Lakemast/WifiCar/WifiCar-PCB/altium_library_brasil-master/README.md

<h1>Bem-Vindo à Altium Library Brasil</h1>

Está é uma Biblioteca de Componentes para o software Altium Design Comunitaria, ela foi pensada em facilitar a vida dos usuarios que precisam gerar a lista de Bill Of Materials para manufaturação de seus produtos ou prototipos.

Contribua incluindo o seu componentes, mas se atente as regras de criação, só assim é possivel manter a biblioteca sempre atualizada.

<h1>Padrão para Schematico</h1>

Todos esquematicos devem conter os seguintes valores

<ul>
  <li>Descrição</li>
  <li>Valor</li>
  <li>Encapsulamento</li>
  <li>Marca</li>
  <li>Modelo</li>
  <li>Observação</li>
</ul>

<h1>Pagina Wiki</h1>

<div><a href="https://github.com/adrianlemos/altium_library_brasil/wiki">Caso queira saber maiores informações de Como fazer Download, Instalar e modificar a Biblioteca, Clique Aqui.</a></div>

<h1>Lista de Componentes</h1>

<h2>Conectores</h2>
<ul>
	<li>Barra de Pinos 2x3 6 vias 180º</li>
	<li>Barra de Pinos 2x4 8 vias 90º</li>
	<li>Barra de Pinos 2x6 12 vias 90º</li>
	<li>Barras de Pinos 3 vias com Jumper</li>
	<li>Jack P4</li>
	<li>Conector KK 3 vias 180º</li>
	<li>Conector BR3R 5 vias 90º</li>
	<li>Conector KK 2 Vias 180º</li>
	<li>Conector Header Sem Ejetor 2x5 10 vias PTH 90º e 180º</li>
	<li>Conector Header Sem Ejetor 2x8 16 vias PTH 90º e 180º</li>
	<li>Conector BR8 3 Vias 90º e 180º</li>
	<li>Conector KRE 2 vias 180º</li>
	<li>Conector KRE 3 vias 180º</li>
</ul>

<h2>Microcontroladores</h2>
<ul>
	<li>ARM Cortex M3 LPC1756 SMD</li>
	<li>ATmega328-AU SMD TQFP32</li>
	<li>ATmega328-PU PTH DIP28</li>
	<li>Microchip 16F628A PTH DIP18</li>
	<li>NXP P80C552EFA</li>
</ul>

<h2>Modulos</h2>
<u>
	<li>Módulo Arduino Pro Mini</li>
	<li>Módulo Wi-Fi ESP-12F</li>
	<li>Módulo Wi-Fi ESP-32</li>
	<li>Módulo Wi-Fi ESP-01</li>
	<li>Display LCD 8x2 YB802-B</li>	
</u>

<h2>Componentes Passivos</h2>
<ul>
	<li>Resistor 	SMD 2512, 2010, 1206, 0805, 0603, 0402</li>
	<li>Capacitor 	SMD 1206, 0805, 0603, 0402</li>
	<li>Capacitor de Tantalo SMD Case B</li>
	<li>Cristal SMD HC49S </li>
	<li>Indutor PTH Carretel 10mm x 12mm 700mA</li>
	<li>Capacitor Eletrolitico Basico PTH com Footprint (Largura x Altura x Passo_do_Pad) 4x5x1.6mm, 5x11x2.54mm, 6.3x11x2.54mm, 8x11x3.5mm, 10x12.5x5.08mm, 10x16x5.08mm, 10x20x5.08mm, 12.5x20x5.08mm, 16x20x7.62mm, 16x25x7.62mm, 16x31.5x7.62mm - SMD </li>
	<li>Capacitor Ceramico PTH com Passo de 5.08mm</li>
	<li>Módulo Ultraminiatura Rele MA1RC2</li>
	<li>Buzzer 5V PTH 180º</li>
	<li>Chave Tact PTH 6x6x5mm</li>
	<li>Chave Tact SMD 6x6x7mm com LED</li>
	<li>Resistor Array 7 vias</li>

</ul>

<h2>Componentes Semicondutores</h2>
<ul>
	<li>Transistor PTH NPN BC550</li>
	<li>Transistor PTH PNP BC560</li>
	<li>Transistor SMD PNP BC807</li>
	<li>Transistor SMD NPN BC817</li>
	<li>OptoAcoplador SMD e PTH PC817</li>
	<li>OptoAcoplador SMD e PTH 4N35</li>
	<li>OptoAcoplador SMD e PTH 6N137</li>
	<li>Regulador de Tensão LM1117 SMD</li>
	<li>OptoAcoplador SMD e PTH MOC3052</li>
	<li>Transiver RS485 MAX485 SMD e PTH</li>
	<li>Diodo SMD LL4148</li>
	<li>Led SMD 1206, 0805 - Sem Cor</li>
	<li>Led 3mm Cores: Amarelo, Azul, Verde, Vermelho PTH</li>
	<li>Led 5mm Cores: Amarelo, Azul, Verde, Vermelho PTH</li>
	<li>Regulador de Tensão 5V 78L05ACM SMD</li>
	<li>Regulador de Tensão 3V3 78L33 SMD e PTH</li>
	<li>Regulador de Tensão fixo e variavel LM2756 SMD, PTH e PTH 90º</li>
	<li>Diodo Schottky SS34 SMD</li>
	<li>Regulador de Tensão LM7805 PTH TO-220 e TO-220 90º</li>
	<li>Sensor de Efeito Hall USS1881 PTH </li>
	<li>Diodo Zenner BZX84 SMD</li>
	<li>Memória EEPROM 24LC64 PTH</li>
	<li>Circuito Integrado Shift Register 74HC595 SMD</li>
	<li>Circuito Integrado MUX 74HC4051</li>
	<li>Transistor PNP Média Potencia BD244</li>
	<li>Diodo Zenner 3V6 SMD</li>
	<li>Diodo Retificador M7</li>
	<li>Diodo de Proteção ESDA6V1L SMD</li>
	<li>Regulador de Tensão LM317 PTH</li>
	<li>Regulador de Tensão LM2576 PTH 90 e 180º, SMD</li>
	<li>Regulador de Tensão Variavel MC34063AD SMD</li>
	<li>Driver de CAN PCA82C251 SMD</li>
	<li>Diodo de Proteção ESD de Rede CAN PESD1CAN</li>
	<li>Diodo Shottky 3A 40V SMAJ26 SMD</li>
	<li>Diodo Shottky SS14 SMD </li>
	<li>Diodo Shottky SS34 SMD </li>
	<li>Transistor NPN de Média Potencia TIP122</li>
	<li>Transistor PNP de Média Potencia TIP127</li>
	<li>TRIAC BTA41-600B PTH </li>
</ul>
