Lakemast/WifiCar/README/voltagedivider.PNG

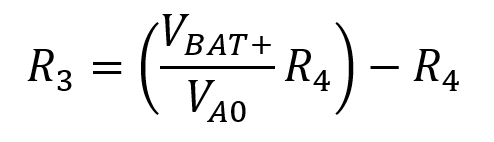
README/voltagedivider.PNG
