Lakemast/WifiCar/(threads)

Thread 1 (2023-01-21):

Can't receive video streaming from WAN

rikiata, 2023-01-21:
Sir,I cant receive espcam32 mqtt image on app.How to cofigure the code or app to receive live video in app?

Lakemast, 2023-01-21:
Hi Friend,

First your smartphone needs to be connected to same WiFi network of your ESP32.
Second you need to change to your **ESP32 IP** the field **Camera URL**  in the APP **Settings**:

- http://**<your_ESP32_IP>**:81/stream
(_replace **<your_ESP32_IP>** with your **ESP32 IP**_)

To do that you need to know what is your **ESP32 IP**.

If you know your **ESP32 IP**  run this small test to ensure your ESP32 is running:
- Open your browser and type your **ESP32 IP** in your web browser
- Something like this image will show

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

Notice that my **ESP32 IP** is  **192.168.15.41** in my LAN (Local Area Network). Now click on _START STREAM_ and some like below the video stream should be shown in your browser.

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

If none of that works please let me know what is your Android Version.

rikiata, 2023-01-21:
Friend,I can access live video on browser(phone or laptop on same wifi.I have changed camera url- http://192.168.1.102:81/stream
but I cant stream video on app screen through mqtt(anywhere in the world).But I can control servo and the motors,Please help.

Lakemast, 2023-01-21:
What is your Android Version ?

Could you please attach a image from app home and settings screen?

Lakemast, 2023-01-21:
Did you install the app through .apk or through Android Studio ?

rikiata, 2023-01-21:
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

ANDROID 10 VERSION

rikiata, 2023-01-21:
I installed the app through apk

rikiata, 2023-01-21:
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

Lakemast, 2023-01-21:
Hi Friend,

I updated the app. Try to install this new uploaded apk [WiFiCar-fixed.apk](https://github.com/Lakemast/WifiCar/blob/master/WiFiCarMQTT/WiFiCar-fixed.apk)

Tell me if it worked.

rikiata, 2023-01-21:
It's working on local wifi. But when I try to connect(4g mobile)  with mqtt, I can control motor,servo and espcam led from anywhere. But can't monitor live video on app.

rikiata, 2023-01-21:
I want to control the car from anywhere in the world through mqtt with live video streaming.

Is it possible?

Lakemast, 2023-01-21:
I got it.

As far as I know MQTT is not a protocol for streaming video.  The only workaround that I know is you make your ESP32 IP static on your Router and use Port Routing and DDNS to access your video stream.

That's why I wrote a disclaimer on project description saying that WAN will require some workaround.

On your Router, you will need to reserve an IP address to ESP32

So you will need sign up at a DDNS provider like  NOIP and register a Domain. _Example: wificar.ddns.net_ and turn up DDNS feature on Router and log in.

After that you need to assign this domain to your  gateway and then port forward to ESP 32 IP and port 81.

I know some chinese cameras app do that with all this workaround, but I didn't find out yet how to do it.

Lakemast, 2023-01-21:
If you do this work around it is possible that video streaming delay will be huge.

Lakemast, 2023-01-21:
Sorry I forgot to say at you do all I said, you will need to change in the App the camera URL with your domain _Example: http://wificar.ddns.net/

rikiata, 2023-01-21:
Did you test the esp32cam on ddns?worked?
Can I use raspberri pi camera url(internet streaming) on your app? If possible, I can control the motors and servo through matt and video streaming through raspberri pi camera.

Or. Can I use v380 camera with your app?

Please suggest.

rikiata, 2023-01-21:
I watched your YouTube video. Video streaming is ddns based or wifi based?

Lakemast, 2023-01-21:
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

Yes I've tested esp32 cam using ddns. It worked but not as expected. The video delay was huge.

Yes, if your camera url is a MJPEG stream you can use my app with raspberry pi camera or any MJPEG camera.

My app used this other repository to stream video
[perthcpe23/android-mjpeg-view)](https://github.com/perthcpe23/android-mjpeg-view)

rikiata, 2023-01-21:
Can you suggest any readymade mjpeg camera?

Lakemast, 2023-01-21:
> I watched your YouTube video. Video streaming is ddns based or wifi based?

None of them.

DDNS stands for Dynamic Domain Name System and is used to translate IP to domains
_example: 142.251.132.238 to google.com_

WiFi is a wireless networking technology that uses radio waves to provide wireless high-speed Internet access. So WiFi basically connects your devices like phone, pc to the router.

Video streaming can be based on several protocols like : RSTP, ONVIF, MJPEG over HTTP and many others.

Lakemast, 2023-01-21:
> Can you suggest any readymade mjpeg camera?

Sorry, but I've worked only with theses modular cameras like esp32cam or raspberry pi cameras.

rikiata, 2023-01-21:
Thanks for your valuable ideas. I will try to make
Mjpeg based raspberri pi internet camera. Then I can control the car from anywhere with live video streaming.

Lakemast, 2023-01-21:
> Thanks for your valuable ideas. I will try to make
> Mjpeg based raspberri pi internet camera. Then I can control the car from anywhere with live video streaming.

You are welcome! Maybe you can find some repository in github to help with at.

Closed 2023-01-21.

Thread 2 (2023-03-01):

Motor always active

rikiata, 2023-03-01:
Dear friend,

I tried to build the hardware.I am facing following errors

1. Motor is automatically switched on whenever I apply power
2. One motor rotates and breaks- continue
3. Ultrasonic sensor is not working
please help

Closed 2023-03-15.
