Lakemast/WifiCar/WifiCar-PCB/WiFiCar-Schematic.pdf

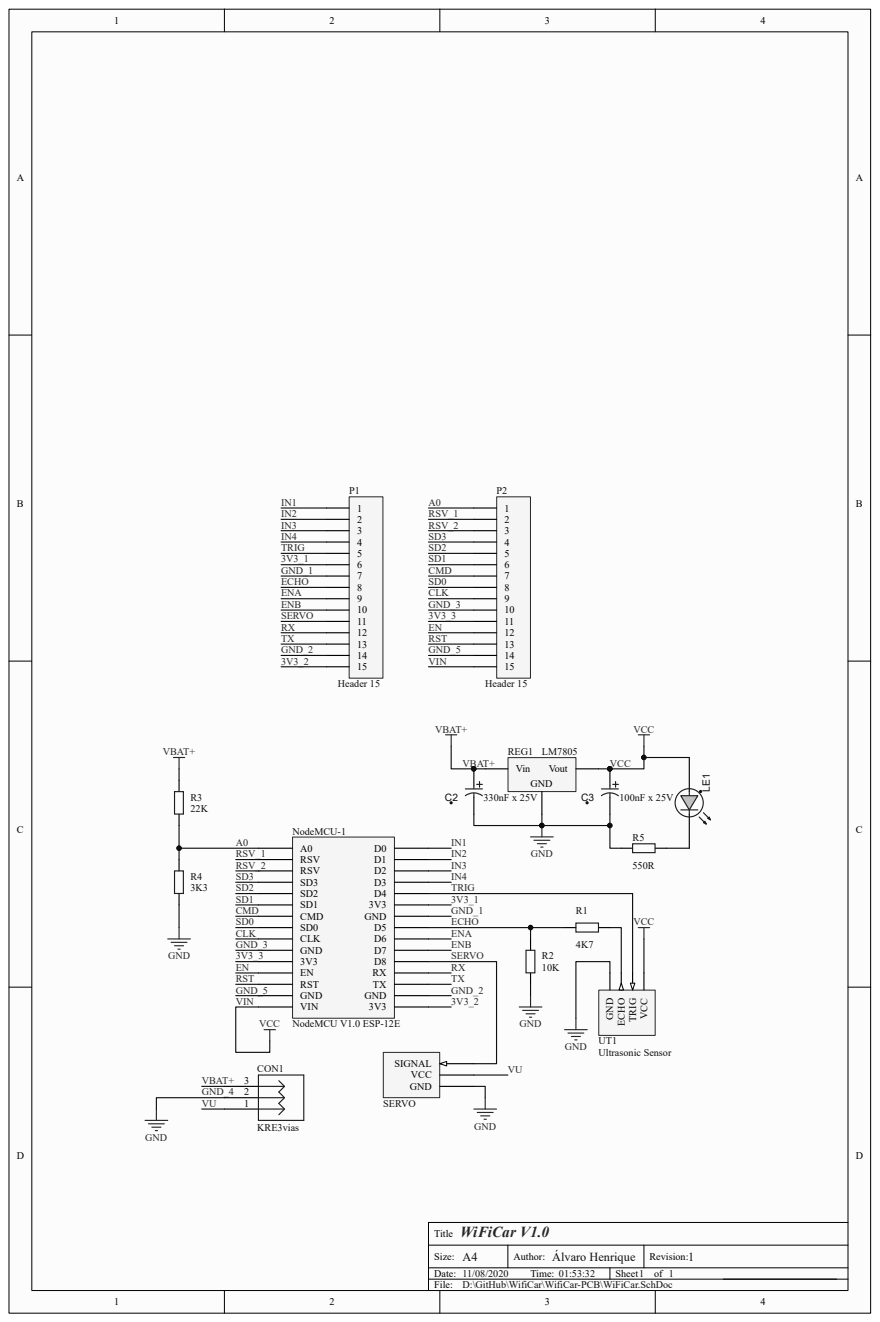
[picture p7: page 1]

WiFiCar V1.0
Title
Size:
D:\GitHub\WifiCar\WifiCar-PCB\WiFiCar.SchDoc
