Lakemast/WifiCar/WifiCar-PCB/WifiCar-PCB-TRANSFER.pdf

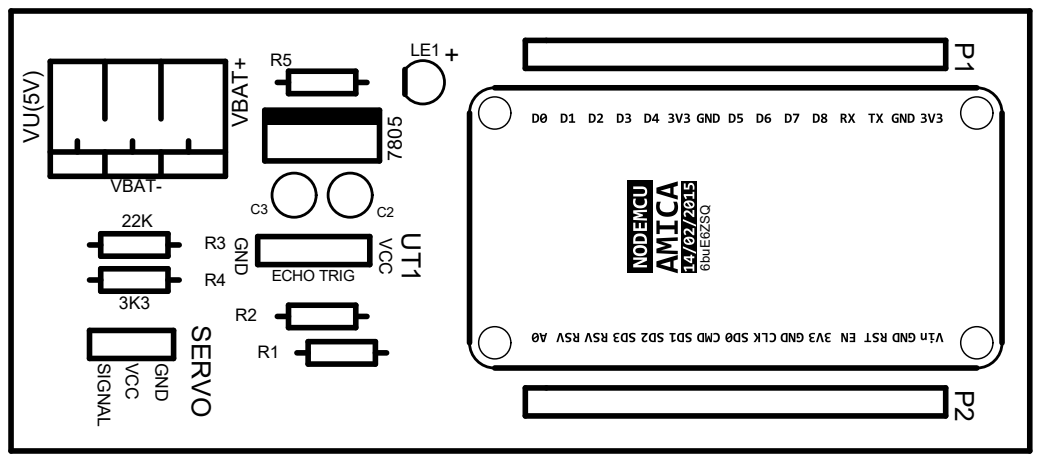
[picture p8: page 1]

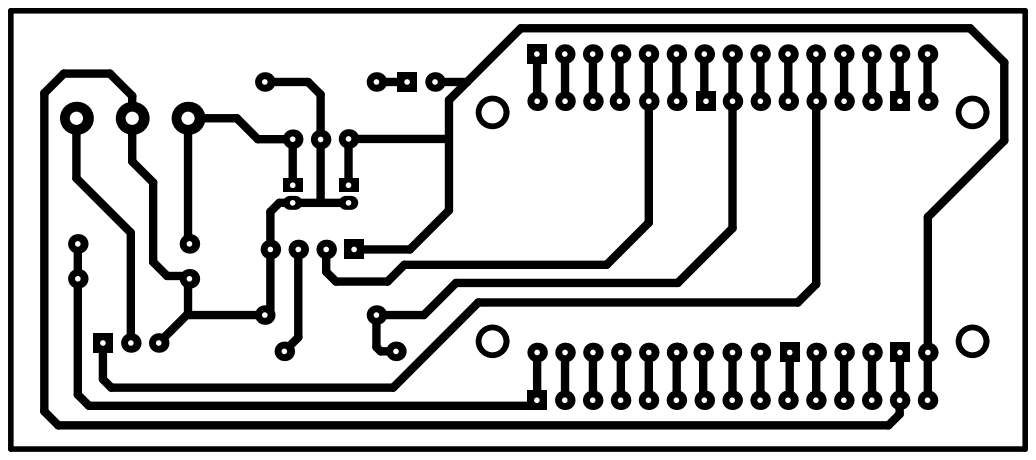
[picture p9: page 2]
