Lakemast/WifiCar/(list of files, drawings)

Other design files:
WifiCar-PCB/altium_library_brasil-master/Altium_Library_Brasil/Conectores_Ftp.PcbLib
WifiCar-PCB/altium_library_brasil-master/Altium_Library_Brasil/Conectores_Sch.SchLib
WifiCar-PCB/altium_library_brasil-master/Altium_Library_Brasil/Geral_Footprints.PcbLib
WifiCar-PCB/altium_library_brasil-master/Altium_Library_Brasil/Microcontroladores_Ftp.PcbLib
WifiCar-PCB/altium_library_brasil-master/Altium_Library_Brasil/Microcontroladores_Sch.SchLib
WifiCar-PCB/altium_library_brasil-master/Altium_Library_Brasil/Modulos_Sche.SchLib
WifiCar-PCB/altium_library_brasil-master/Altium_Library_Brasil/Passivos_Ftp.PcbLib
WifiCar-PCB/altium_library_brasil-master/Altium_Library_Brasil/Passivos_Sche.SchLib
WifiCar-PCB/altium_library_brasil-master/Altium_Library_Brasil/Semicondutores_Ftp.PcbLib
WifiCar-PCB/altium_library_brasil-master/Altium_Library_Brasil/Semicondutores_Sche.SchLib
WifiCar-PCB/WIFICAR.PcbLib
WifiCar-PCB/WifiCar.PrjPcb
WifiCar-PCB/WiFiCar.SchDoc
WifiCar-PCB/WifiCar.SCHLIB
WifiCar-PCB/WifiCarPcbDoc.PcbDoc
