Lakemast/WifiCar/WiFiCarMQTT/app/src/main/java/com/example/wificar/mqtt/PahoMqttClient.java

package com.example.wificar.mqtt;

import android.content.Context;
import android.content.SharedPreferences;
import android.util.Log;

import androidx.annotation.NonNull;

import org.eclipse.paho.android.service.MqttAndroidClient;
import org.eclipse.paho.client.mqttv3.DisconnectedBufferOptions;
import org.eclipse.paho.client.mqttv3.IMqttActionListener;
import org.eclipse.paho.client.mqttv3.IMqttToken;
import org.eclipse.paho.client.mqttv3.MqttConnectOptions;
import org.eclipse.paho.client.mqttv3.MqttException;
import org.eclipse.paho.client.mqttv3.MqttMessage;

import java.io.UnsupportedEncodingException;

/**
 * Created by brijesh on 20/4/17.
 */

public class PahoMqttClient {

    private static final String TAG = "PahoMqttClient";
    public MqttAndroidClient mqttAndroidClient;
    private SharedPreferences sharedPreferences;
    private String clientid = "", urlBroker = "", username = "", password = "", subscribeTopic = "", publishTopic = "";
    private final static String PREF_BROKER = "PREF_BROKER", PREF_USERNAME = "PREF_USERNAME", PREF_PASSWORD = "PREF_PASSWORD",
            PREF_SUBSCRIBE = "PREF_SUBSCRIBE", PREF_PUBLISH = "PREF_PUBLISH",
            PREF_MAX_SPEED_MOTOR_A = "PREF_MAX_SPEED_MOTOR_A", PREF_MAX_SPEED_MOTOR_B = "PREF_MAX_SPEED_MOTOR_B";


    public MqttAndroidClient getMqttClient(Context context, String brokerUrl, String clientId, String clientUn, String clientPw) {
        mqttAndroidClient = new MqttAndroidClient(context, brokerUrl, clientId);
        try {
            MqttConnectOptions myMqttcnxoptions = getMqttConnectionOption();
            if(clientUn.trim().length() > 0) {
                myMqttcnxoptions.setUserName(clientUn);
            }
            if(clientPw.trim().length() > 0) {
                myMqttcnxoptions.setPassword(clientPw.toCharArray());
            }
            IMqttToken token = mqttAndroidClient.connect(myMqttcnxoptions);

            //IMqttToken token = mqttAndroidClient.connect(getMqttConnectionOption(clientUn,clientPw));
            token.setActionCallback(new IMqttActionListener() {
                @Override
                public void onSuccess(IMqttToken asyncActionToken) {
                    mqttAndroidClient.setBufferOpts(getDisconnectedBufferOptions());
                    Log.d(TAG, "Success");
                }

                @Override
                public void onFailure(IMqttToken asyncActionToken, Throwable exception) {
                    Log.d(TAG, "Failure " + exception.toString());
                }
            });
        } catch (MqttException e) {
            e.printStackTrace();
        }

        return mqttAndroidClient;
    }

    public void disconnect(@NonNull MqttAndroidClient client) throws MqttException {
        IMqttToken mqttToken = client.disconnect();
        mqttToken.setActionCallback(new IMqttActionListener() {
            @Override
            public void onSuccess(IMqttToken iMqttToken) {
                Log.d(TAG, "Successfully disconnected");
            }

            @Override
            public void onFailure(IMqttToken iMqttToken, Throwable throwable) {
                Log.d(TAG, "Failed to disconnected " + throwable.toString());
            }
        });
    }

    @NonNull
    private DisconnectedBufferOptions getDisconnectedBufferOptions() {
        DisconnectedBufferOptions disconnectedBufferOptions = new DisconnectedBufferOptions();
        disconnectedBufferOptions.setBufferEnabled(true);
        disconnectedBufferOptions.setBufferSize(100);
        disconnectedBufferOptions.setPersistBuffer(false);
        disconnectedBufferOptions.setDeleteOldestMessages(false);
        return disconnectedBufferOptions;
    }

    @NonNull
    private MqttConnectOptions getMqttConnectionOption() {

        //private MqttConnectOptions getMqttConnectionOption(String clientUn, String clientPw) {
        MqttConnectOptions mqttConnectOptions = new MqttConnectOptions();
        mqttConnectOptions.setCleanSession(false);
        mqttConnectOptions.setAutomaticReconnect(true);
        //mqttConnectOptions.setWill(Constants.PUBLISH_TOPIC, "I am going offline".getBytes(), 1, true);
        //mqttConnectOptions.setUserName("dave_test1");
        //mqttConnectOptions.setPassword("dave_test123".toCharArray());
        //mqttConnectOptions.setUserName(un);
        //mqttConnectOptions.setPassword(clientPw.toCharArray());
        return mqttConnectOptions;
    }

    public void publishMessage(@NonNull MqttAndroidClient client, @NonNull String msg, int qos, @NonNull String topic)
            throws MqttException, UnsupportedEncodingException {
        byte[] encodedPayload = new byte[0];
        encodedPayload = msg.getBytes("UTF-8");
        MqttMessage message = new MqttMessage(encodedPayload);
        message.setId(320);
        message.setRetained(true);
        message.setQos(qos);
        client.publish(topic, message);
    }

    public void subscribe(@NonNull MqttAndroidClient client, @NonNull final String topic, int qos) throws MqttException {
        IMqttToken token = client.subscribe(topic, qos);
        token.setActionCallback(new IMqttActionListener() {
            @Override
            public void onSuccess(IMqttToken iMqttToken) {
                Log.d(TAG, "Subscribe Successfully " + topic);
            }

            @Override
            public void onFailure(IMqttToken iMqttToken, Throwable throwable) {
                Log.e(TAG, "Subscribe Failed " + topic);

            }
        });
    }

    public void unSubscribe(@NonNull MqttAndroidClient client, @NonNull final String topic) throws MqttException {

        IMqttToken token = client.unsubscribe(topic);

        token.setActionCallback(new IMqttActionListener() {
            @Override
            public void onSuccess(IMqttToken iMqttToken) {
                Log.d(TAG, "UnSubscribe Successfully " + topic);
            }

            @Override
            public void onFailure(IMqttToken iMqttToken, Throwable throwable) {
                Log.e(TAG, "UnSubscribe Failed " + topic);
            }
        });
    }

}
