Lakemast/WifiCar/(commit log)

2020-05-07 teste de commit no arquivo gitTest.txt
2020-05-08 Criação da primeira versão dos sketchs para o NodeMCU
2020-05-09 motors and ultrasonic functions implemented
2020-05-09 Trying to work with a servo
2020-05-10 Improvement on ultrasonic
2020-05-10 Improvement on decteting and avoiding obstacles.
    [motors.ino, mqtt.ino, ultrasonic.ino]
2020-05-11 Battery Voltmeter implemented
2020-05-11 Improvement on detecting and avoiding obstacles.
    [ultrasonic.ino]
2020-05-12 Added schematics and pcb layouts
    [WiFiCar.SchDoc, WifiCar.PrjPcb, WifiCar.SCHLIB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]
2020-05-12 WiFiCar PDF schematic
2020-05-13 PCB and Schematics fixed; PCB library added; All docs created on Altium 16v
    [WIFICAR.PcbLib, WiFiCar.SchDoc, WifiCar.PrjPcb, WifiCar.SCHLIB, WifiCarPcbDoc.PcbDoc]
2020-05-15 Android app integration implemented.
    [app_bar_main.xml]
2020-05-17 wrong obstacle avoidance fixed.
    [app_bar_main.xml]
2020-05-17 Enhanced MQTT Android APP.
    [app_bar_main.xml]
2020-05-20 PWM issues fixed.
    [Conectores_Ftp.PcbLib, Conectores_Sch.SchLib, Geral_Footprints.PcbLib, Microcontroladores_Ftp.PcbLib, Microcontroladores_Sch.SchLib, Modulos_Sche.SchLib, Passivos_Ftp.PcbLib, Passivos_Sche.SchLib]
2020-05-20 Motor speed problems fixed.
    [WiFiCar.SchDoc, WifiCar.PrjPcb, WifiCar.SCHLIB, WifiCarPcbDoc.PcbDoc]
2020-06-04 Smooth Drive methods implemented
    [WifiCarPcbDoc.PcbDoc]
2020-06-23 Added ESP32 CAM Sketch, app integration and servo controll.
    [app_bar_main.xml]
2020-08-09 Schematic revised
    [WiFiCar.SchDoc, WifiCar.PrjPcb]
2020-08-09 Schematic image
2020-08-09 Diy PCB masks
2020-08-11 Schematic Revised!
2020-08-11 Revised schematics!
2020-08-12 Schematic added!
2020-10-02 Added voltage divider formula
2022-11-14 Cleartext HTTP traffic not permitted fixed and Larger CamView
    [HomeFragment.java]
2023-01-21 Clear Text HTTP not permitted fixed
    [mqtt.ino, ultrasonic.ino]
